MiGeRA/famicom-dumper-writer/FamicomDumper_board.png

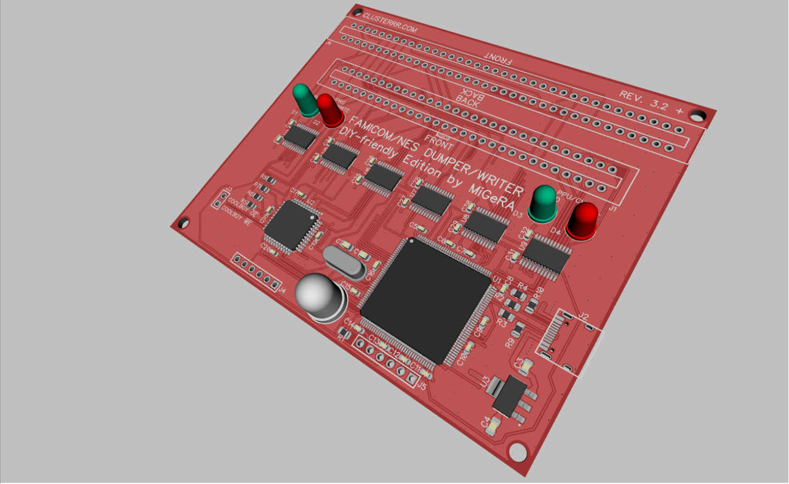
FamicomDumper_board.png
