MiGeRA/famicom-dumper-writer/(list of files, drawings)

Other design files:
FamicomDumper_restyle.dip
