MiGeRA/famicom-dumper-writer/(commit log)

2024-08-31 Delete board directory
    Not relevant
    [FamicomDumper_board.dip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]
2024-08-31 Restyle DIY-friendly Edition
    [FamicomDumper_restyle.dip]
2024-09-28 Custom self-sign driver for Win7
